SvenG19740/ArduinoHdmiSonySlink/Arduino_Mega_Slink_HDMI.jpg

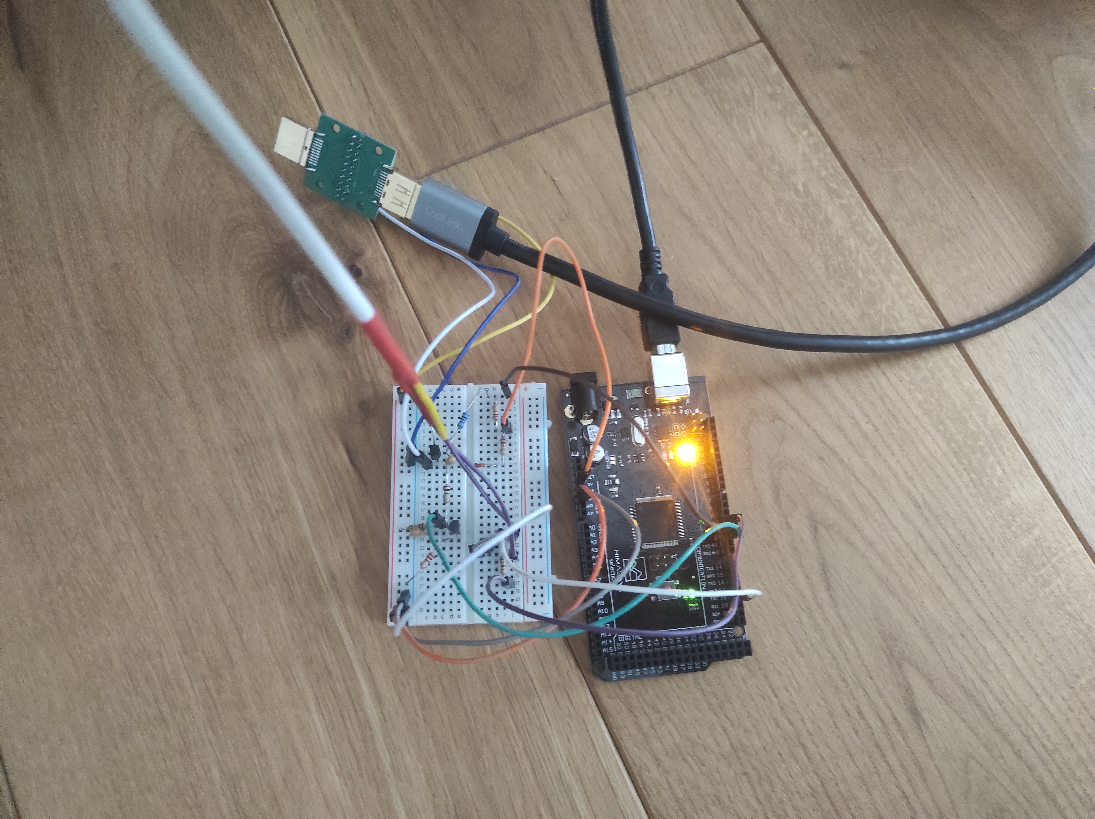
Arduino_Mega_Slink_HDMI.jpg
