SvenG19740/ArduinoHdmiSonySlink/Arduino_Nano_Slink_HDMI.jpg

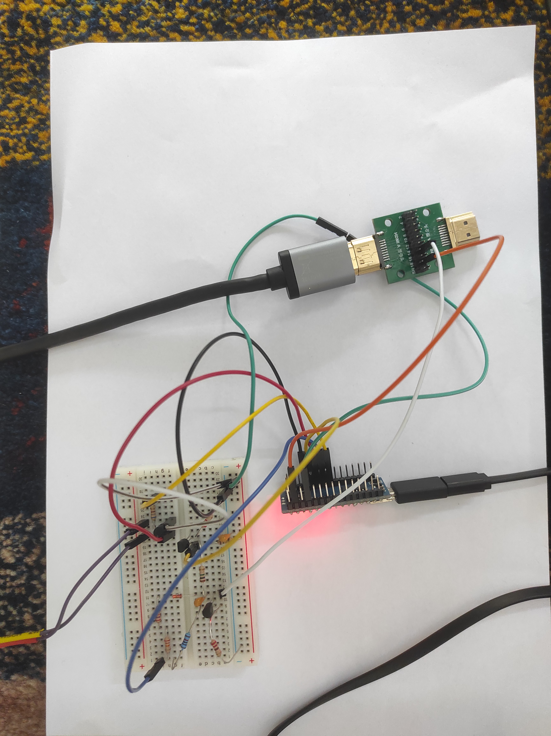
Arduino_Nano_Slink_HDMI.jpg
