SvenG19740/ArduinoHdmiSonySlink/Arduino_HDMI_SonySlink_Schaltplan.png

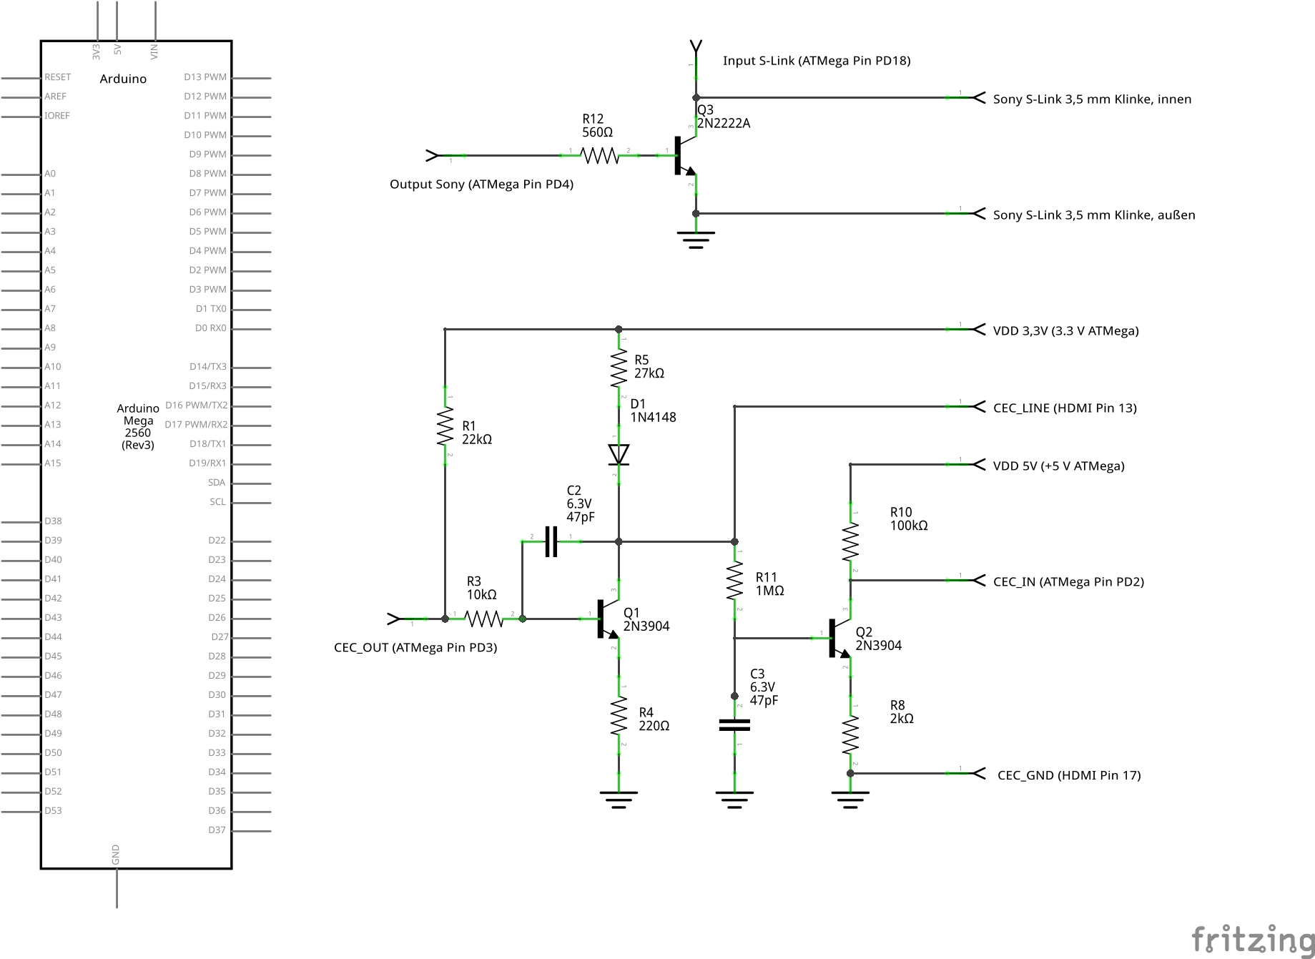
Arduino_HDMI_SonySlink_Schaltplan.png
