SvenG19740/ArduinoHdmiSonySlink/Arduino_HDMI_SonySlink_Schaltplan.pdf

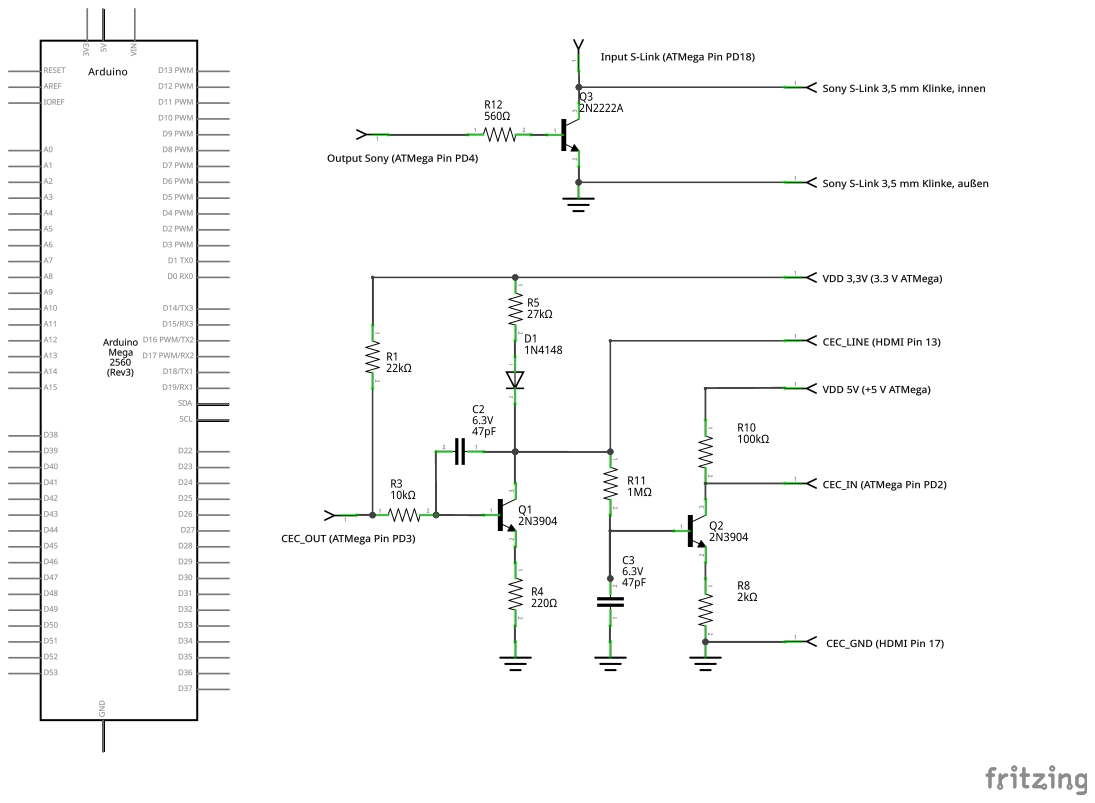
[picture p4: page 1]
