SvenG19740/ArduinoHdmiSonySlink/(commit log)

2026-08-12 Uploaded schematics
2026-08-12 Added code for Arduino
    Code created and compiled in Arduino IDE 2.3.4
2026-08-20 2 pictures from breadboard with Arduino Nano / Mega uploaded
    Pictures show 2 variants
    - a breadboard try-out setup with Arduino Mega and connection to S-Link and HDMI
    - a breadboard try-out setup with Arduino Nano and connection to S-Link and HDMI
    Both versions do work. You turn on the TV set with your remote control and the Sony amplifier / receiver gets powered on. Furthermore you may change the volume and mute.
2026-08-20 Update README.md
    Code and schematic tested with Arduino Nano
2026-09-02 Update README.md
    +5 V of HDMI at TV set cannot be used
